EdisonDesign/HealthOS/README.md

# HealthOS
These are the CAD files that are available as an open-source, build-it-yourself kit that is made up of easy to source parts from local hardware and electronics shops as well as some 3D printed parts. The main features are a simple bellow design that is driven by twin geared motors vertically with speeds being adjusted by a simple motor control unit.
