EdisonDesign/HealthOS/Edison HealthOS Dual MDF STEP V0.1/Edison HealthOS Dual MDF v0.1.step

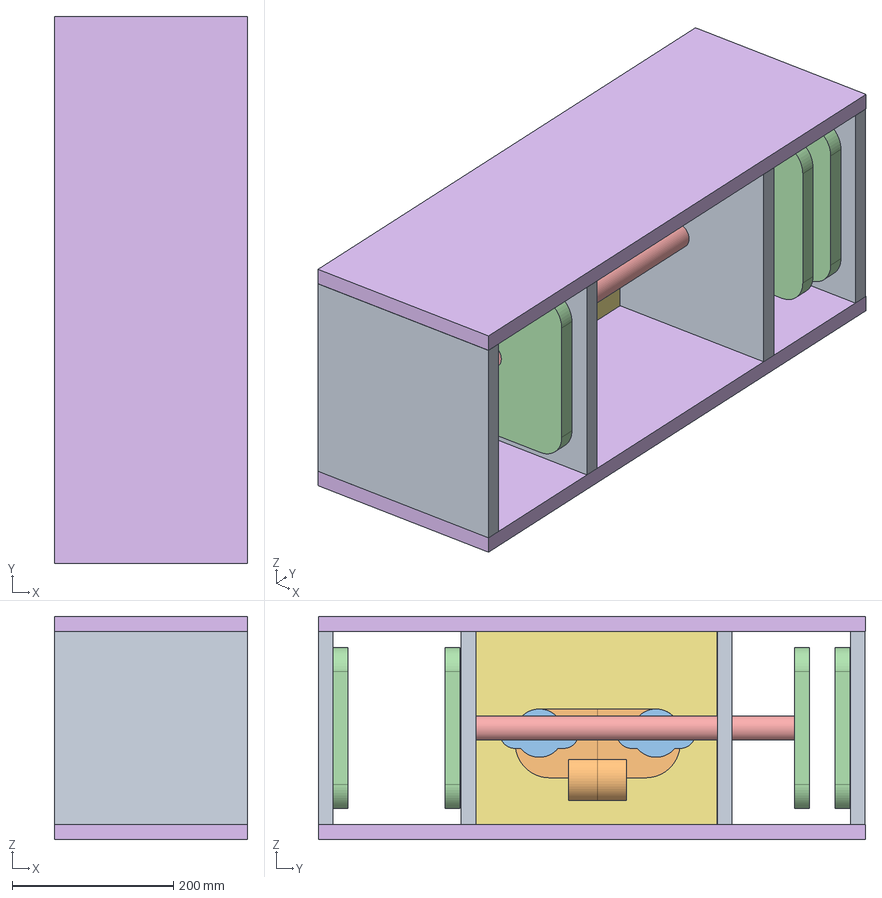
[picture p2: CAD file, 2020-03-27]
Edison HealthOS Dual MDF STEP V0.1/Edison HealthOS Dual MDF v0.1.step
240.0 x 680.0 x 277.0 mm
EndWall x 2
MassageMotor
Wall1 x 2
PlungerBottom x 2
BroomStick
Base x 2
PlungerTop x 2
MotorMountWall
