EdisonDesign/HealthOS/Edison HealthOS Ventilator_STL for PrintV0.5/Bracket v9.stl

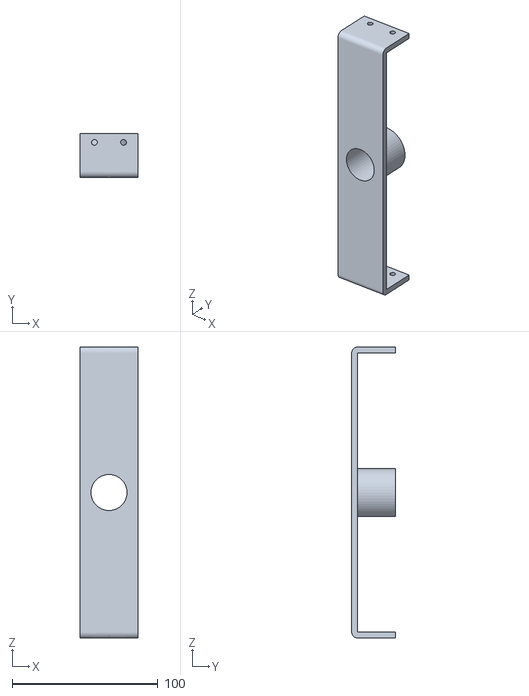
[picture p3: CAD file, 2020-03-25]
Edison HealthOS Ventilator_STL for PrintV0.5/Bracket v9.stl
40.0 x 30.0 x 200.0
