EdisonDesign/HealthOS/Edison HealthOS Ventilator_STL for PrintV0.5/Disc v14.stl

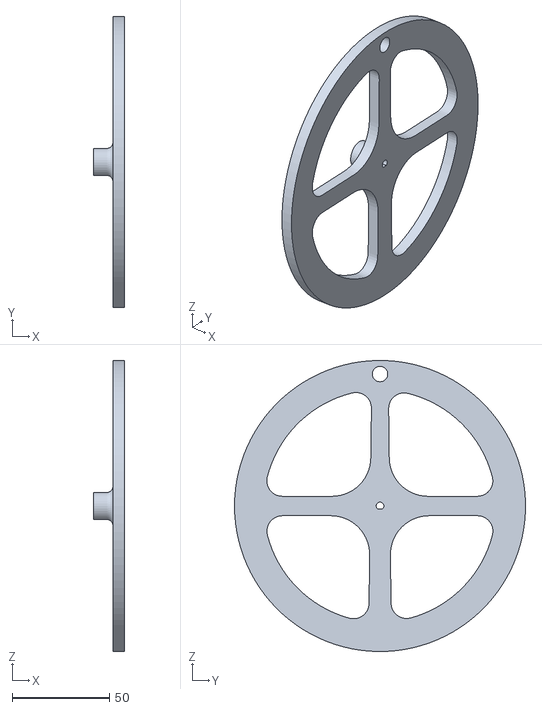
[picture p4: CAD file, 2020-03-25]
Edison HealthOS Ventilator_STL for PrintV0.5/Disc v14.stl
16.0 x 150.0 x 150.0
