EdisonDesign/HealthOS/Edison HealthOS Ventilator_STL for PrintV0.5/ExitPipe v5.stl

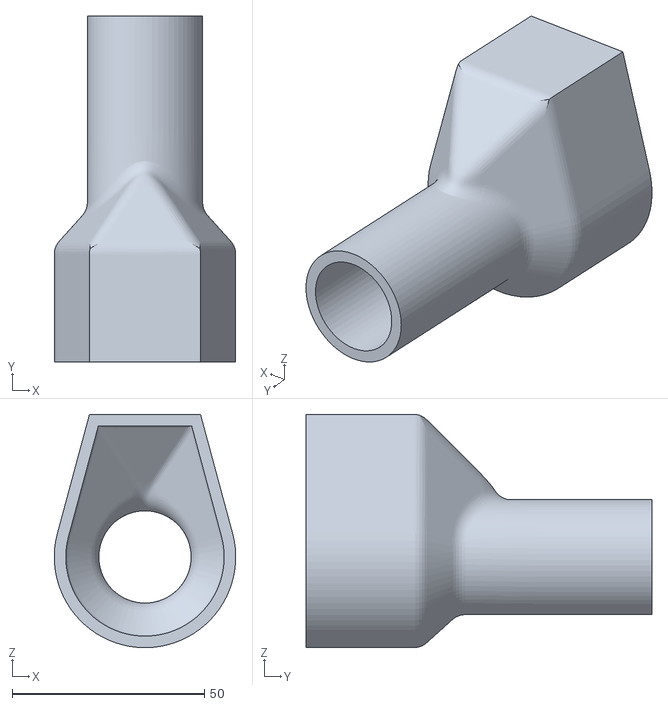
[picture p5: CAD file, 2020-03-25]
Edison HealthOS Ventilator_STL for PrintV0.5/ExitPipe v5.stl
47.2 x 90.0 x 60.7
