EdisonDesign/HealthOS/Edison HealthOS Ventilator_STL for PrintV0.5/LowerMembraneEnd v12.stl

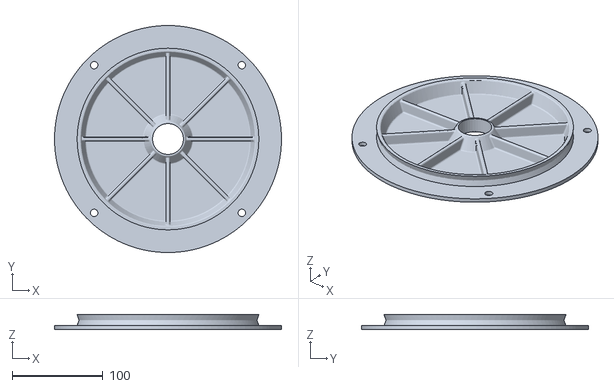
[picture p6: CAD file, 2020-03-25]
Edison HealthOS Ventilator_STL for PrintV0.5/LowerMembraneEnd v12.stl
250.0 x 249.9 x 16.0
