EdisonDesign/HealthOS/Edison HealthOS Ventilator_STL for PrintV0.5/Plunger v24.stl

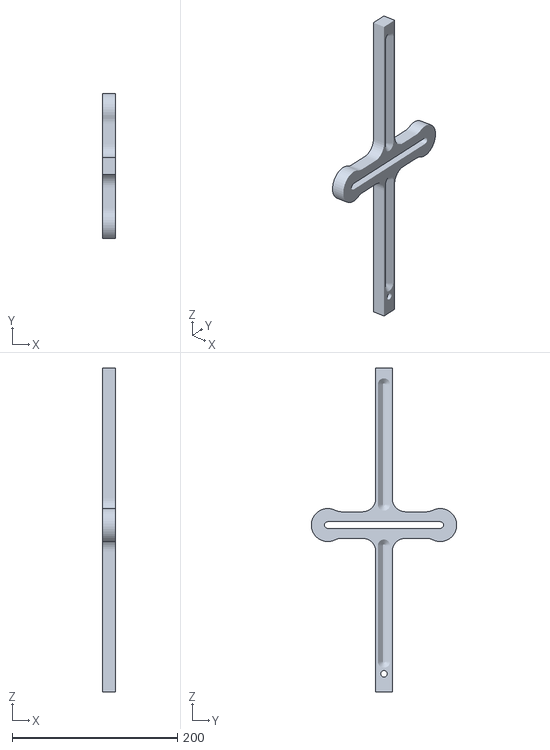
[picture p7: CAD file, 2020-03-25]
Edison HealthOS Ventilator_STL for PrintV0.5/Plunger v24.stl
16.0 x 175.9 x 392.0
