EdisonDesign/HealthOS/Edison HealthOS Ventilator_STL for PrintV0.5/UpperMembraneEnd v13.stl

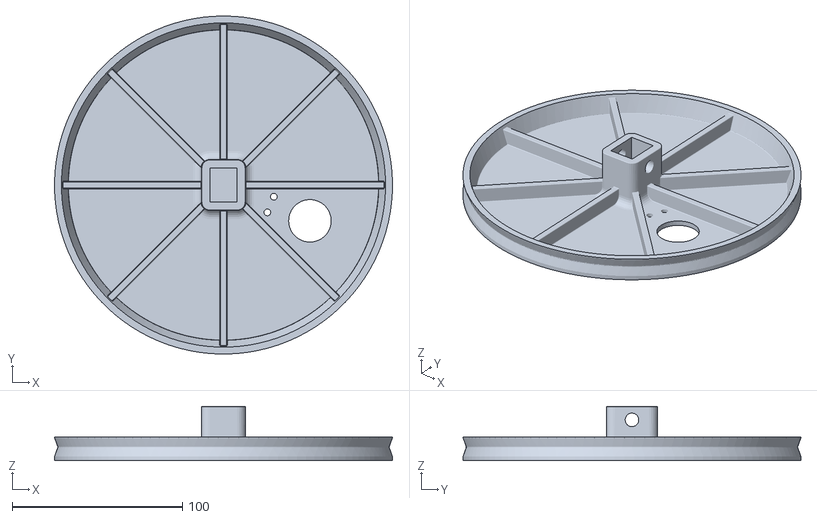
[picture p8: CAD file, 2020-03-25]
Edison HealthOS Ventilator_STL for PrintV0.5/UpperMembraneEnd v13.stl
198.7 x 198.7 x 32.0
