EdisonDesign/HealthOS/Edison HealthOS Ventilator_STL for PrintV0.5/MiddlePlate2 v25.stl

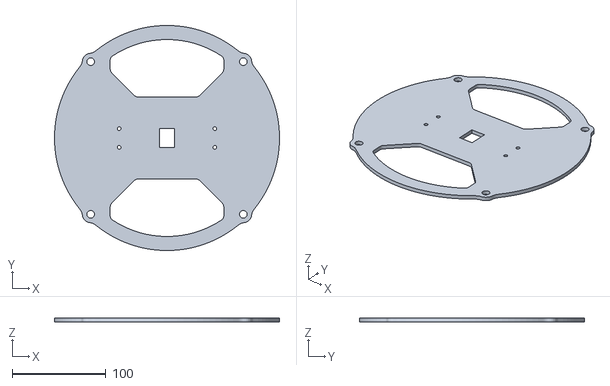
[picture p9: CAD file, 2020-03-25]
Edison HealthOS Ventilator_STL for PrintV0.5/MiddlePlate2 v25.stl
239.9 x 239.9 x 4.00
