EdisonDesign/HealthOS/Edison HealthOS Ventilator_STL for PrintV0.5/TopPlate v9.stl

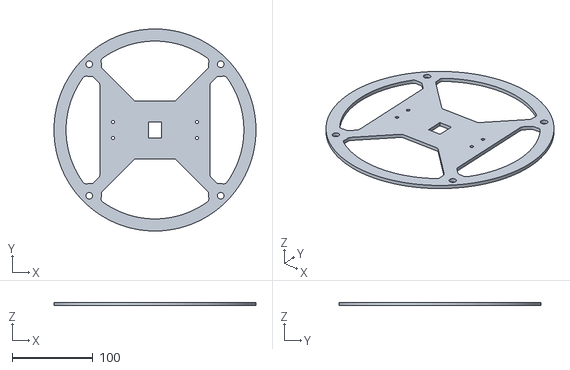
[picture p10: CAD file, 2020-03-23]
Edison HealthOS Ventilator_STL for PrintV0.5/TopPlate v9.stl
249.9 x 250.0 x 4.00
