EdisonDesign/HealthOS/Edison HealthOS Ventilator_STL for PrintV0.5/Outlet Pipe v10.stl

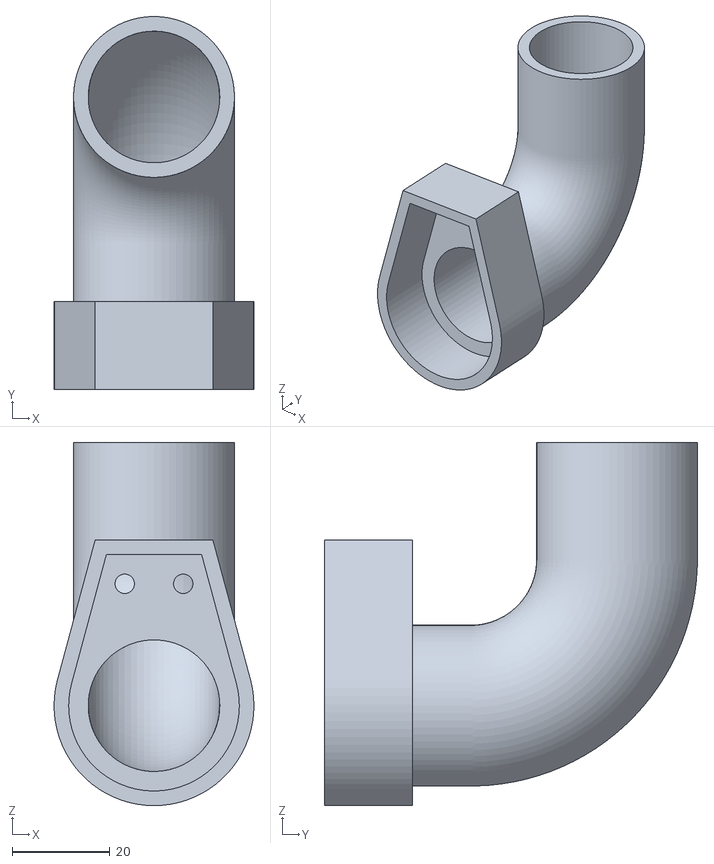
[picture p11: CAD file, 2020-03-23]
Edison HealthOS Ventilator_STL for PrintV0.5/Outlet Pipe v10.stl
41.0 x 76.5 x 74.5
