EdisonDesign/HealthOS/Edison HealthOS Ventilator_STL for PrintV0.5/BottomPlate v6.stl

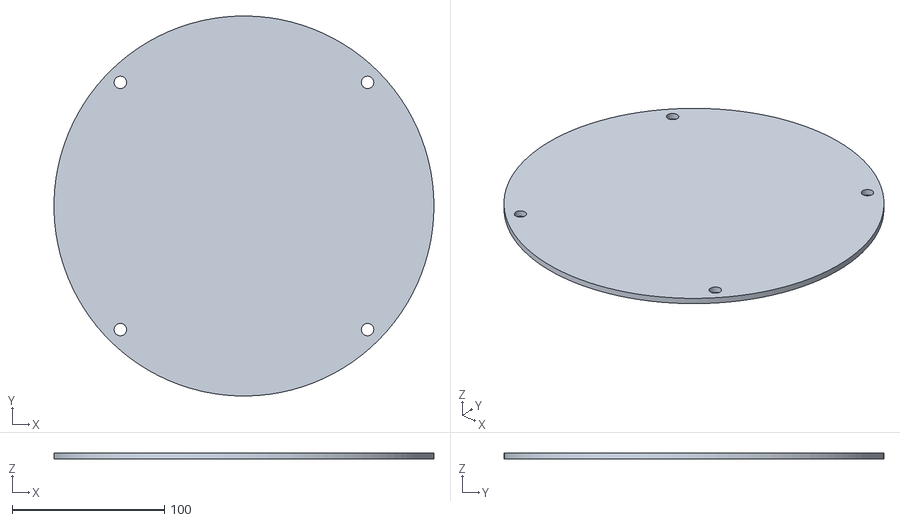
[picture p12: CAD file, 2020-03-23]
Edison HealthOS Ventilator_STL for PrintV0.5/BottomPlate v6.stl
249.9 x 250.0 x 4.00
