EdisonDesign/HealthOS/Edison HealthOS Ventilator_STL for PrintV0.5/LowerMembraneEnd v11.stl

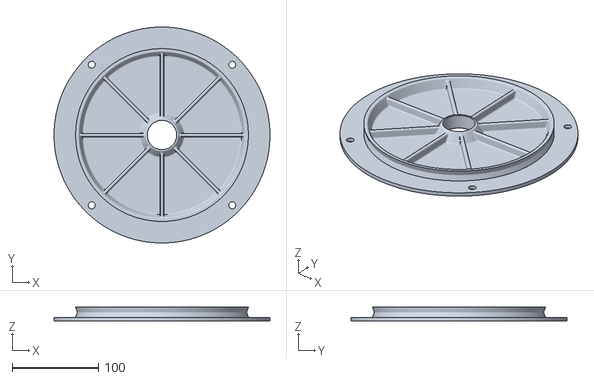
[picture p13: CAD file, 2020-03-25, an earlier design]
Edison HealthOS Ventilator_STL for PrintV0.5/LowerMembraneEnd v11.stl
250.0 x 249.9 x 16.0
