EdisonDesign/HealthOS/Edison HealthOS Dual MDF Ventilator Build Instructions V0.1.pdf

200 A | A | A-A (1:10)

200Ø30 R30

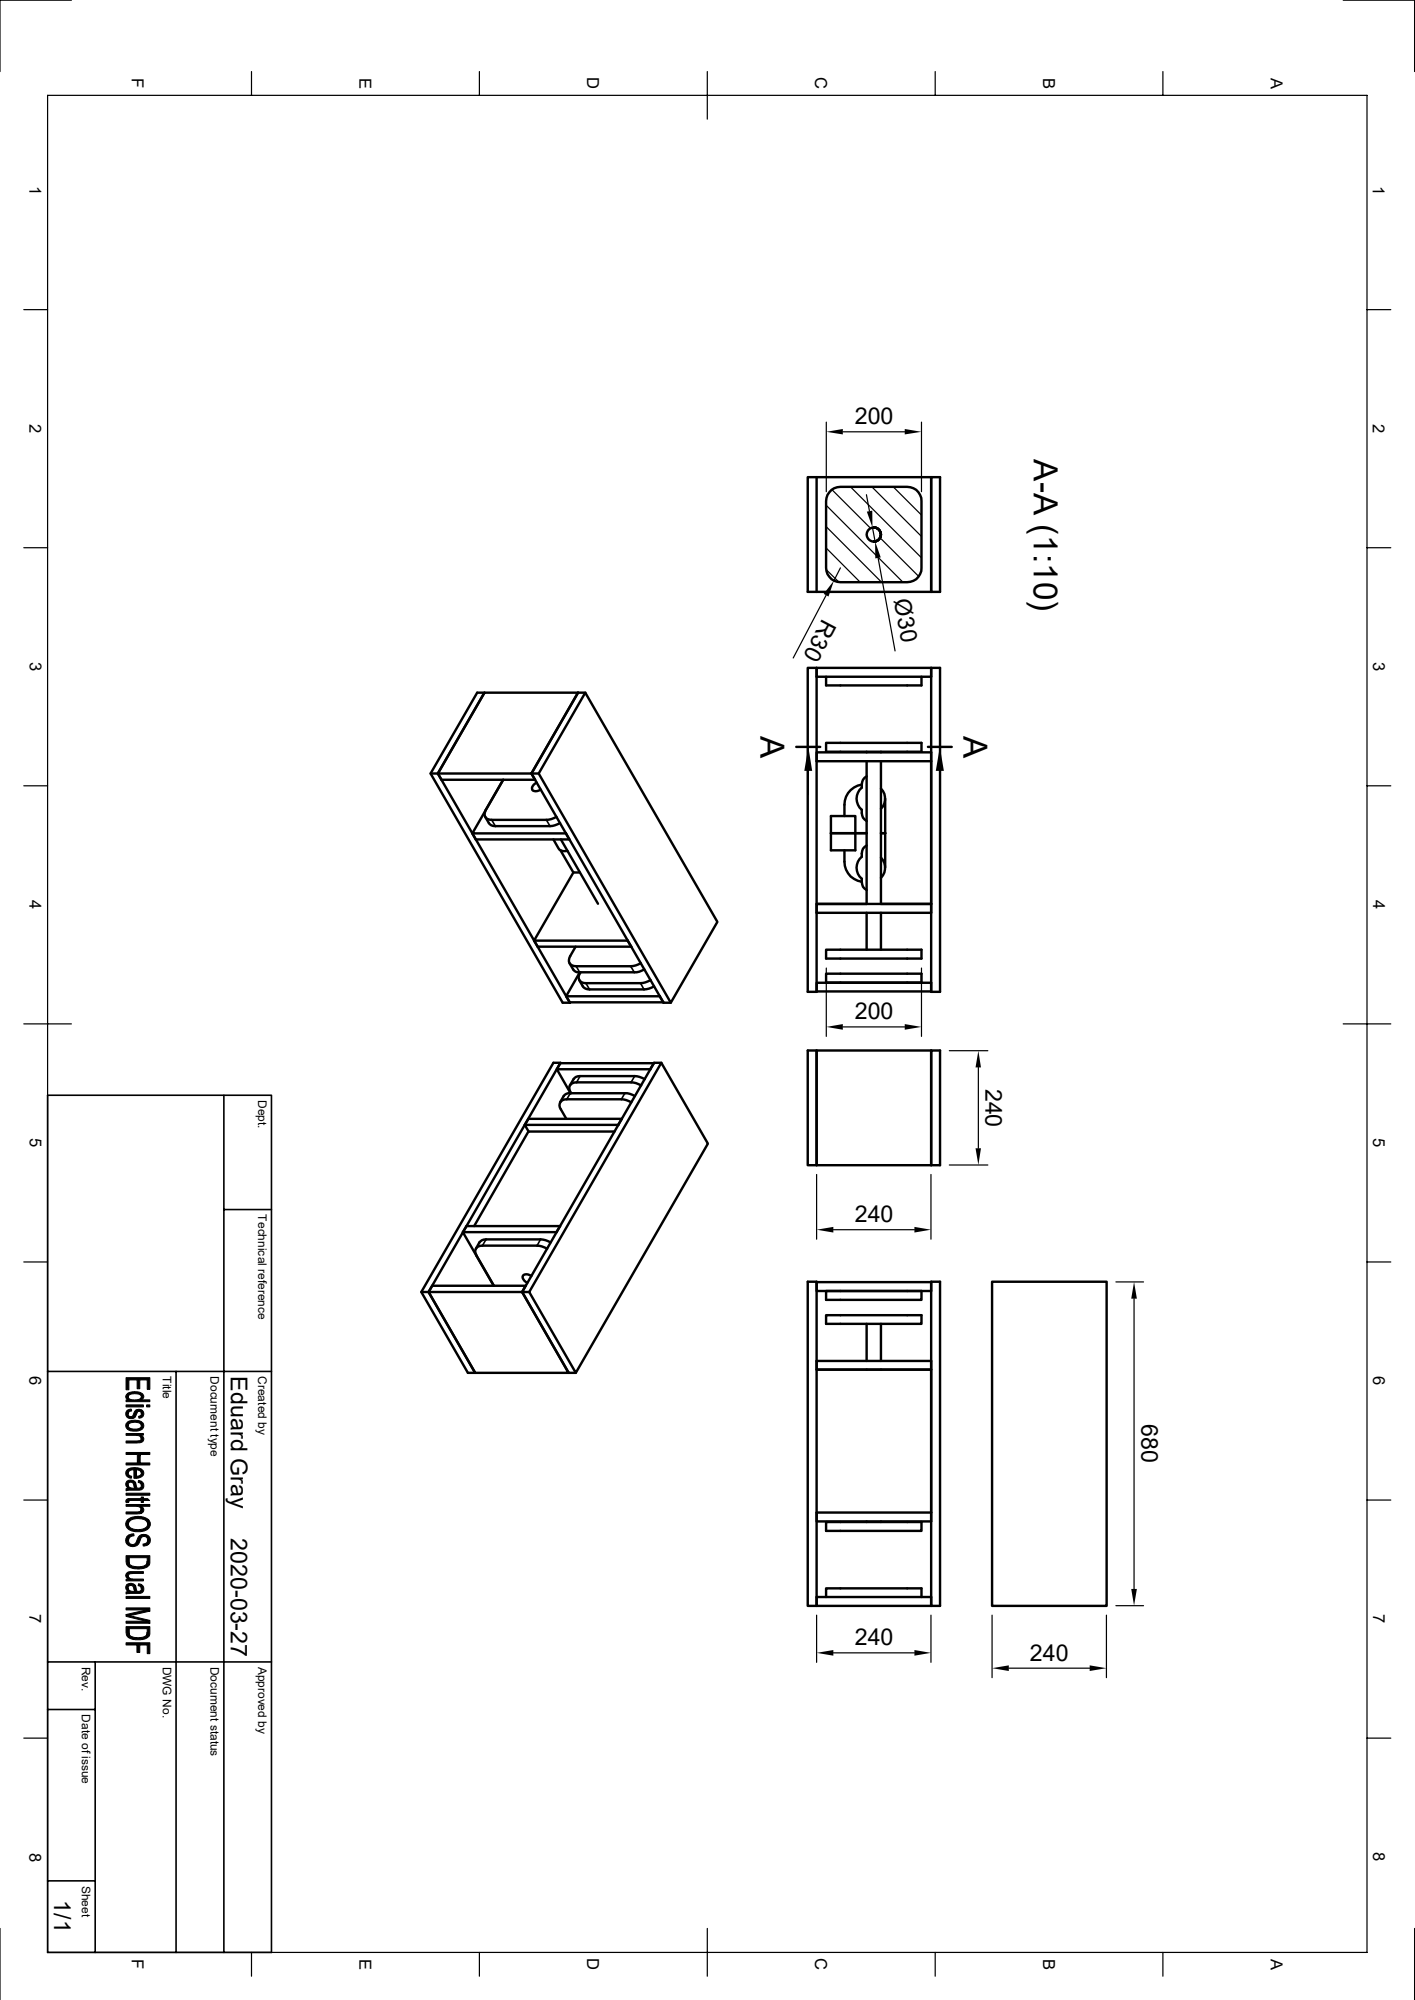
[picture p14: page 1]

1 A 2 3 4 5 6 7 8 1 2 3 4 5 6 7 8 FEDCB FEDCBA Dept. Technical reference Created by Approved by Title DWG No. Document type Document status Rev. Date of issue Sheet 2020-03-27 1/1 Eduard Gray 680
