EdisonDesign/HealthOS/Instructions/Instructions_A_0002.png

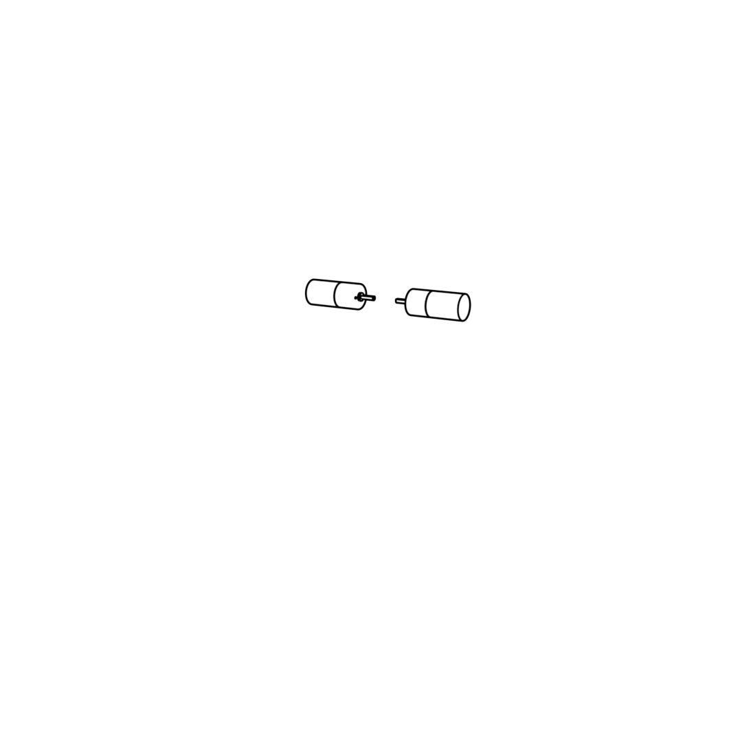
Instructions/Instructions_A_0002.png
