EdisonDesign/HealthOS/Instructions/Instructions_A_0003.png

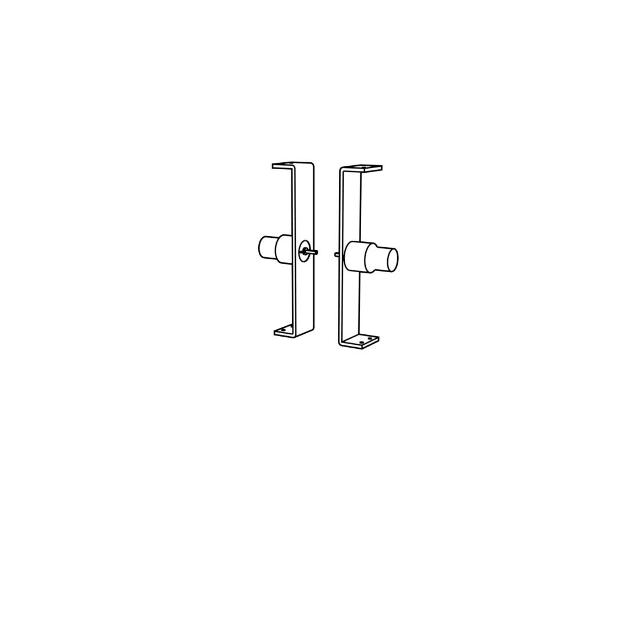
Instructions/Instructions_A_0003.png
