EdisonDesign/HealthOS/Instructions/Instructions_A_0007.png

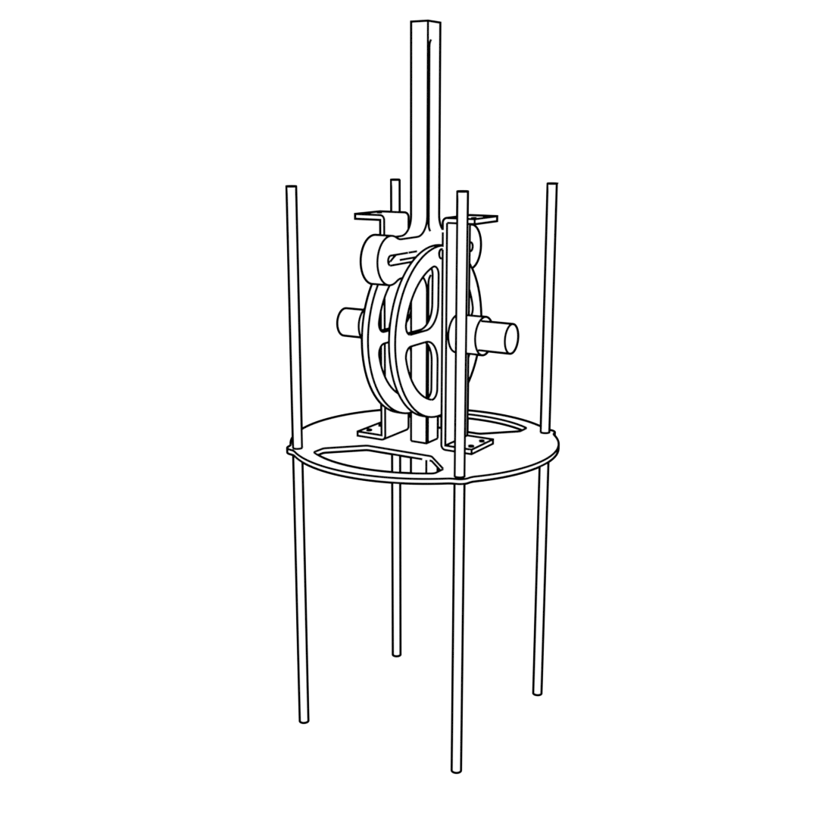
Instructions/Instructions_A_0007.png
