EdisonDesign/HealthOS/Instructions/Instructions_A_0017.png

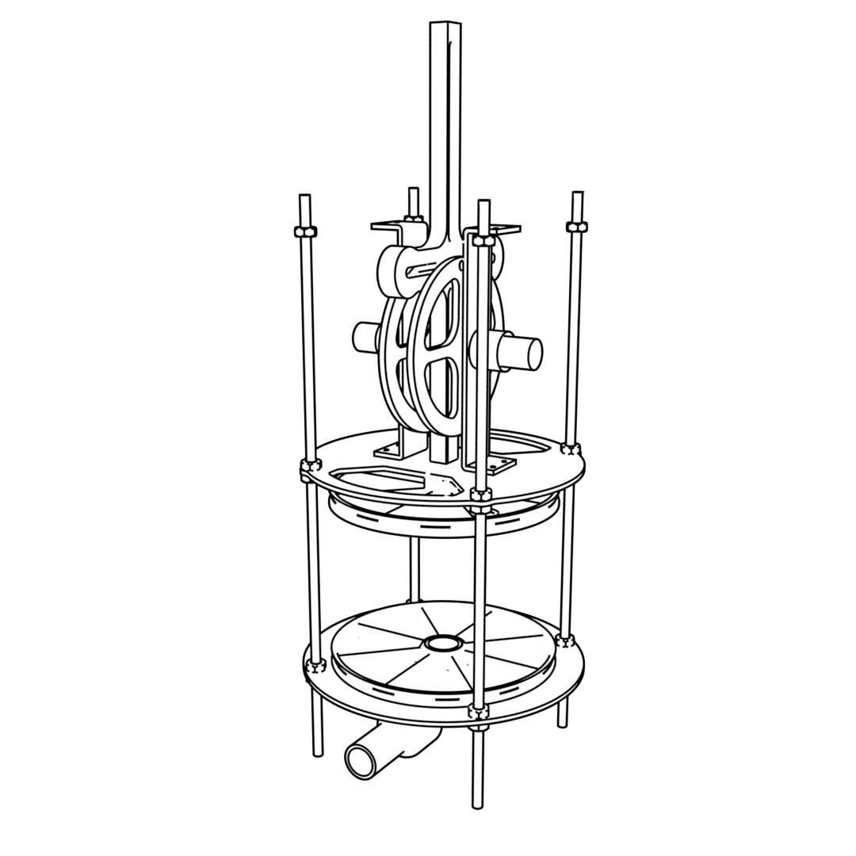
Instructions/Instructions_A_0017.png
