EdisonDesign/HealthOS/Instructions/Instructions_A_0022.png

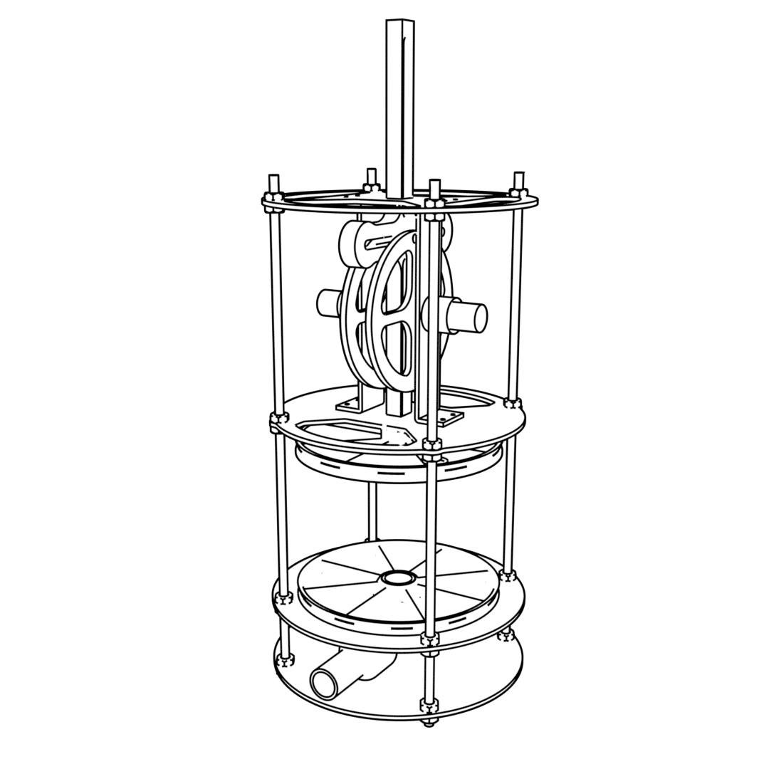
Instructions/Instructions_A_0022.png
