EdisonDesign/HealthOS/Instructions/Instructions_A_0023.png

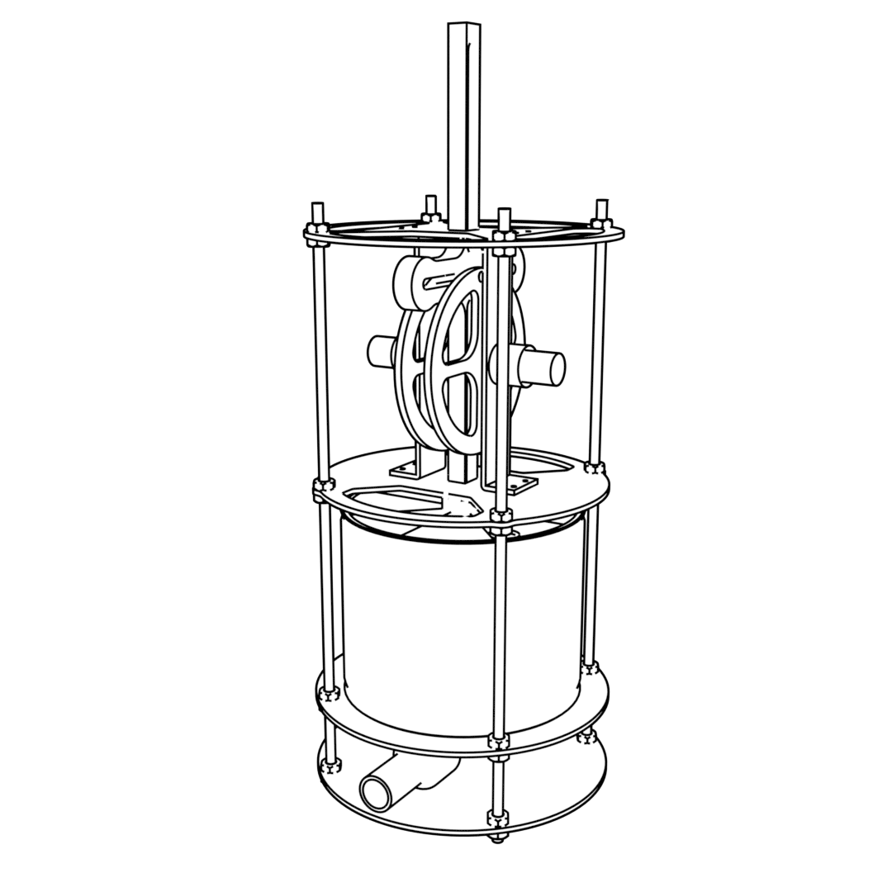
Instructions/Instructions_A_0023.png
