EdisonDesign/HealthOS/(threads)

Thread 1 (2020-03-24):

Digital shield STL

Kels316, 2020-03-24:
Hi - just a note on the STL for the digital shield. The design doesn't sit flat on the build plate and therefore requires supports, which adds a manual (and time consuming) step in the process. If you're going to print, rather than injection mold, you might consider changing the design to remove the need for supports.
