EdisonDesign/HealthOS/(commit log)

2020-03-24 New gearing mechanism for stronger motors
    [HealthOS Assy v15.step]
2020-03-25 Strengthened components and press fit motor mountings
    [HealthOS Assy v0.5.step]
2020-03-25 V0.5 STL files
    [BottomPlate v6.stl, Bracket v9.stl, Disc v14.stl, ExitPipe v5.stl, LowerMembraneEnd v11.stl, LowerMembraneEnd v12.stl, MiddlePlate2 v25.stl, Outlet Pipe v10.stl]
2020-03-25 Visual assembly instructions
2020-03-27 Dual MDF Board Ventilator Plans
2020-03-27 Step files for Dual MDF Ventilator V0.1
    [Edison HealthOS Dual MDF v0.1.step]
